jpwolfe31/Remote-Control-Keypad-App-for-DSC-Impassa-WT5500/photos/IMG_2073.jpg

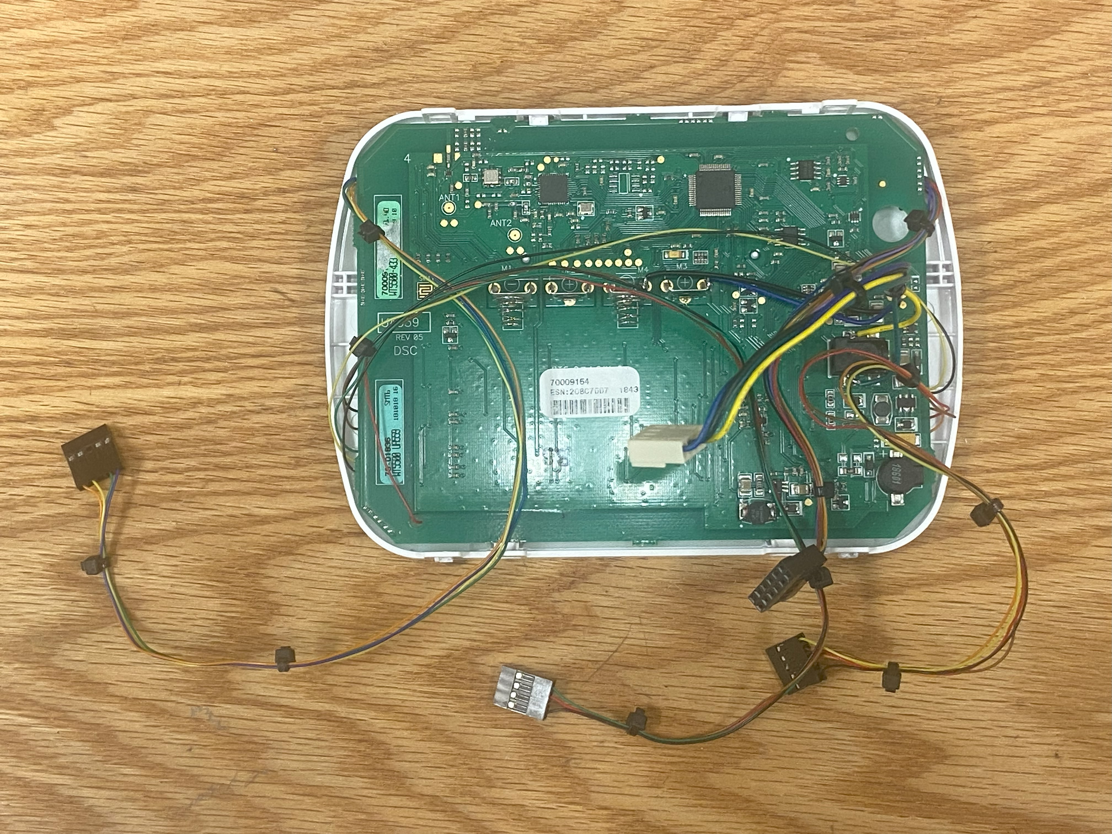
photos/IMG_2073.jpg
