jpwolfe31/Remote-Control-Keypad-App-for-DSC-Impassa-WT5500/photos/IMG_E1976.JPG

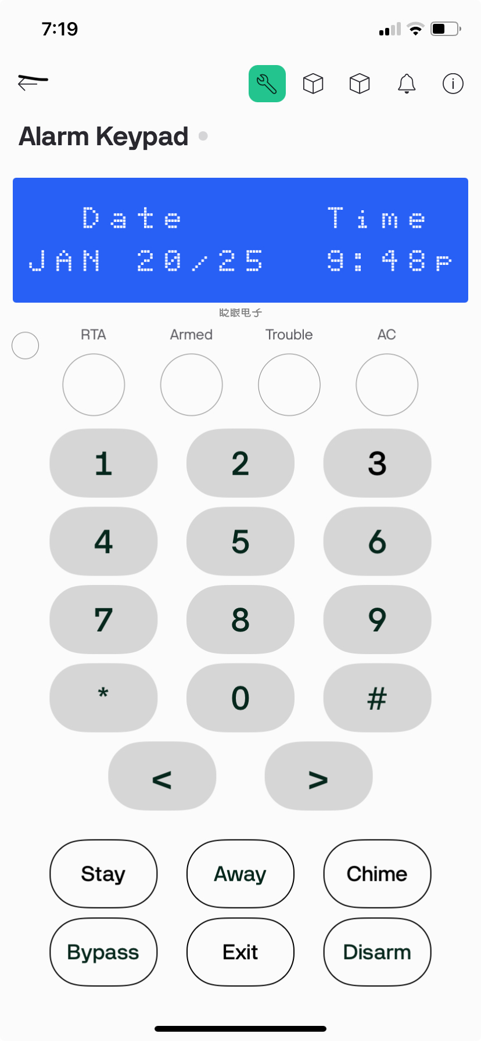
photos/IMG_E1976.JPG
