jpwolfe31/Remote-Control-Keypad-App-for-DSC-Impassa-WT5500/photos/Panel Bd back labels.jpg

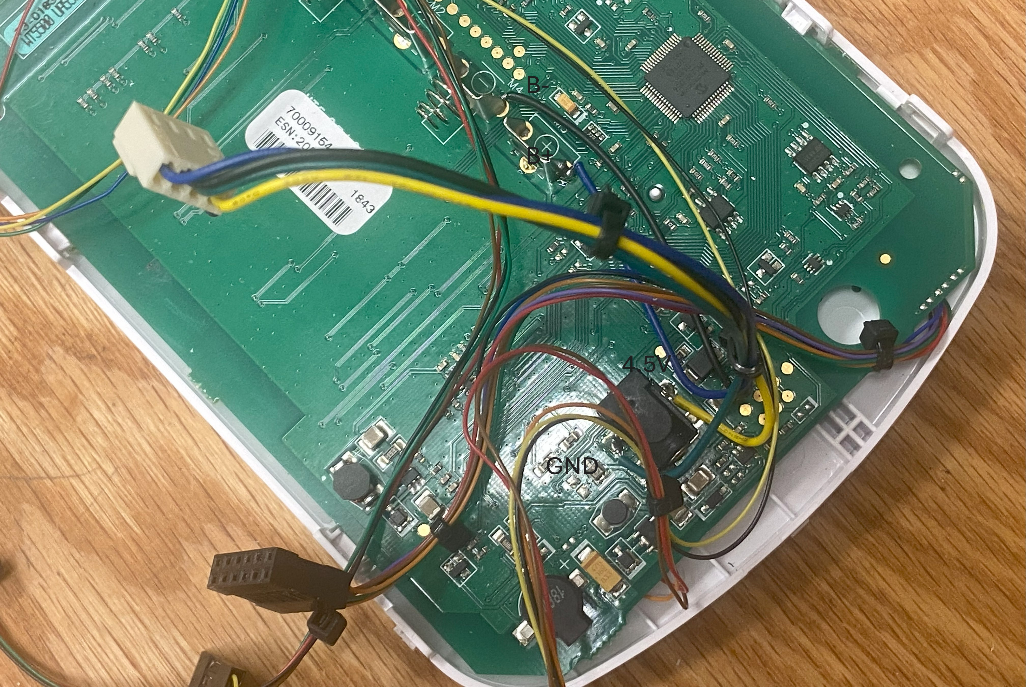
photos/Panel Bd back labels.jpg
