jpwolfe31/Remote-Control-Keypad-App-for-DSC-Impassa-WT5500/Alarm Keyboard Schematic 2025-02-10.pdf

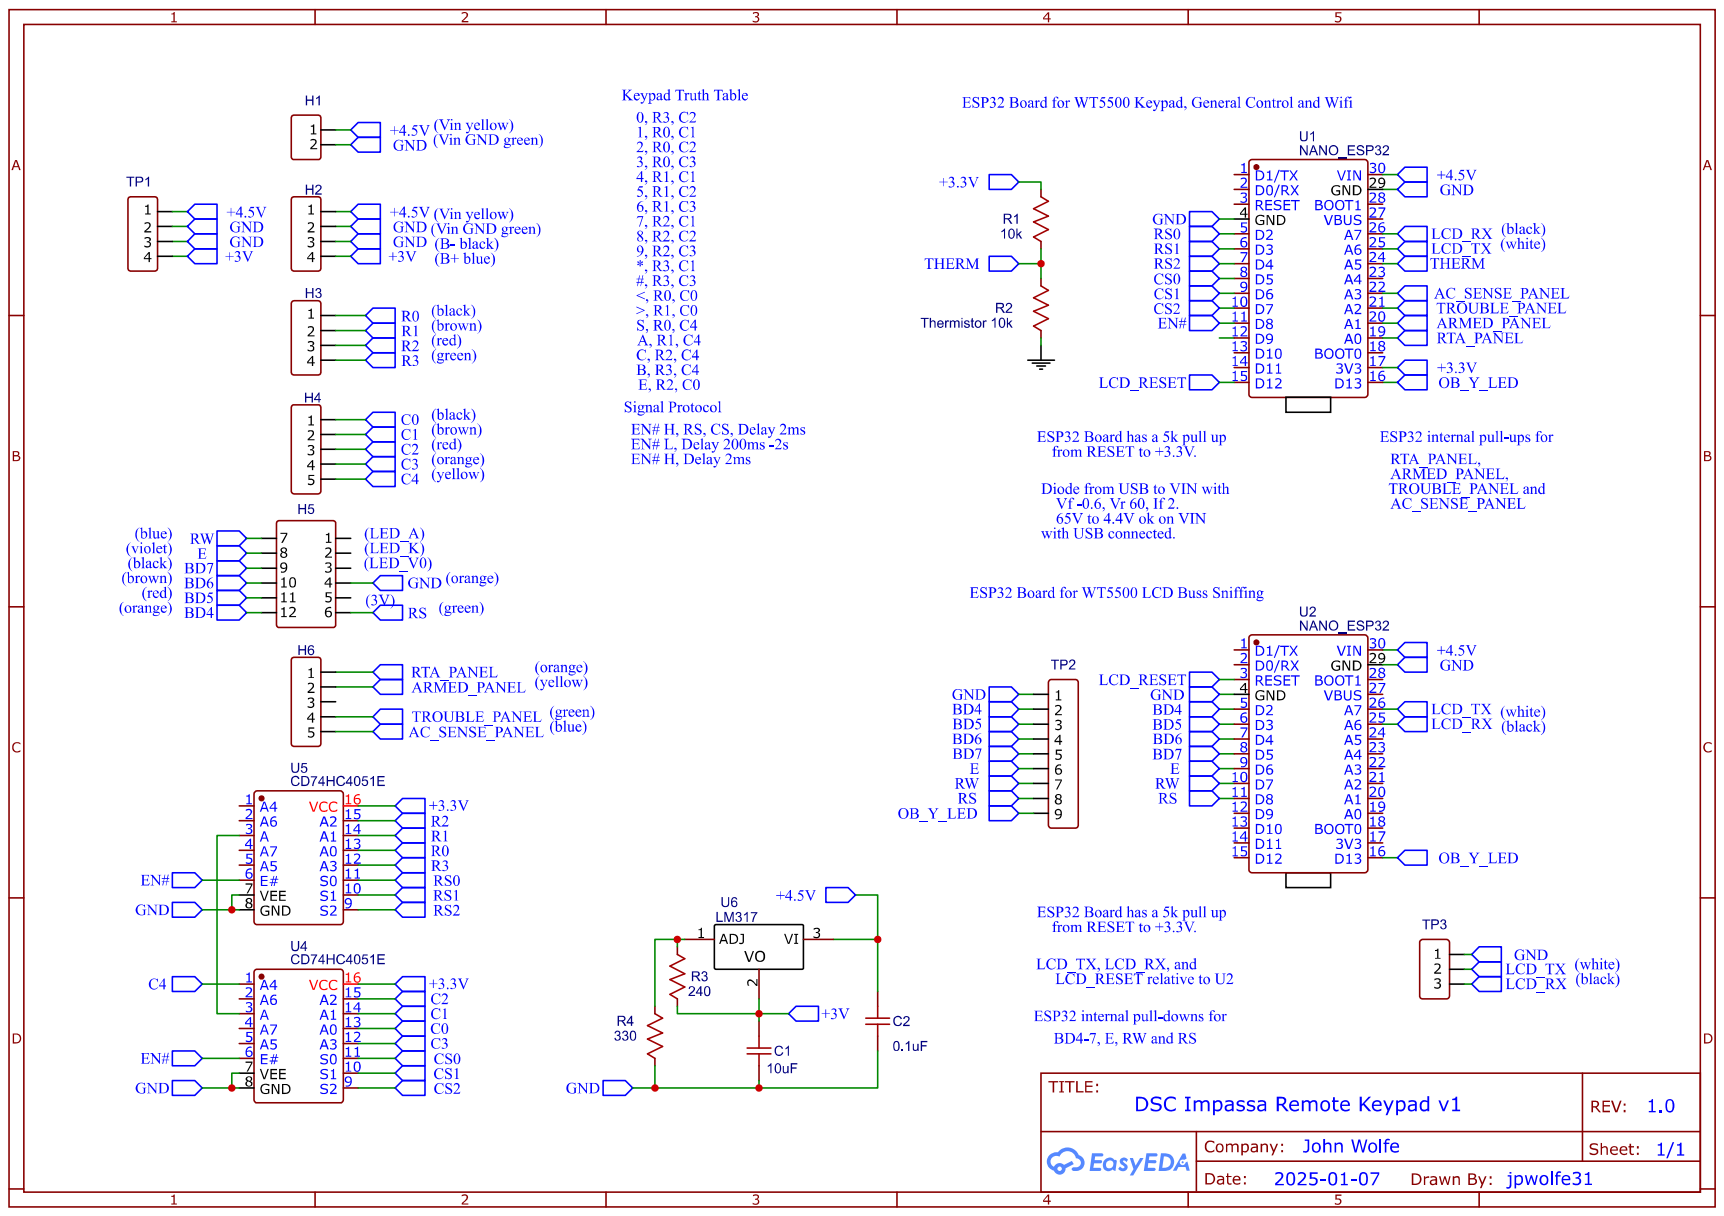
[picture p26: page 1]
